AgRoboticsResearch/sroi_v2/README_ch.md

# SROI 手持数采装置 / 草莓采摘末端执行器

一套用于草莓采摘的**末端执行器**，具备两种使用形态：

- **手持数据采集形态** —— 由握把 + 板机式「录制触发按键」驱动，配合 RealSense D405 相机与空间定位 Tracker，用于采集遥操作 / 示教数据。
- **关节电机形态** —— 末端接口对接关节电机外法兰，由电机直接驱动，可挂载于机械臂执行实际采摘。

两种形态共用同一套「平行夹爪 + 直线导轨」传动末端，仅更换「摇杆转接件」与驱动源即可切换。

> 想复刻？准备材料看 [BOM 清单](BOM.md)，照着 [装配指南](#装配指南) 组装即可。

---

## 目录结构

```
第三版设计/
├── 3DModel/                 # SolidWorks 源文件
│   ├── *.SLDPRT             # 零件(自绘)
│   ├── *.SLDASM             # 装配体(手持 / 关节电机两套)
│   ├── 五金件/              # 紧固件 / 轴承参考模型(不打印，仅供装配对照)
│   └── STL/                 # 用于 3D 打印的导出件
├── BOM.md                   # 物料清单(唯一权威来源)
└── README.md
```

> `STL/` 仅包含**需要 3D 打印**的零件；标准件(直线导轨、滑块、轴承)在 `3DModel/` 下提供 `.SLDPRT` 仅供装配参考，**需外购**。

---

## 机构原理

末端采用 **摇杆 + 连杆 + 直线导轨** 的传动方案，把单一旋转输入转换为夹爪的平行开合：

```
手持：按下 按钮(线性) ──▶ 核心块转轴上的 U 型凸轮槽 ──▶ 转轴(旋转)
电机：电机轴 ──▶ 摇杆-转接电机 ──▶ 摇杆(旋转)
                                  │
                                  ▼
                        摇杆(旋转 5° → 50°)
                                  │  连杆 ×2
                                  ▼
              转接块 ── MGN9C 滑块 ── 沿 MGN9 导轨平移
                                  │
                                  ▼
                         平行夹爪 开 / 合
        松手后由按钮腔内的压簧提供回复力(夹爪自动张开)。
```

**关键传动参数(小开度配置)：**

| 参数 | 数值 |
|---|---|
| 摇杆旋转行程 | 45°(5° → 50°) |
| 对应滑块行程 | 24 mm |
| 当前导轨长度 | MGN9 156 mm(全开 ~96 mm) |

> **设计取舍**：圆弧形凸轮槽虽意图让传动更平顺，但实测会在中段产生「夹爪不动 → 冲击」的死区，反而更难控制；最终采用**直线的 U 型槽**，并在闭合段调整角度以放大夹持力——这是平顺性与夹持力之间的折中解(详见 [版本差异](#版本差异))。

---

## 物料清单 (BOM)

完整物料清单维护在独立文件中：**👉 [BOM.md](BOM.md)**

概览：18 类 3D 打印件 · 杯头/沉头/平头内六角螺丝 · 内六角打塞螺丝(M4 台阶螺丝)· MGN9 + MGN5 直线导轨 · MR115 法兰轴承 · D405 / Tracker / Raspberry Pi / 电池。

> BOM 是「购物清单」(按规格汇总数量)，下方装配指南是「装在哪」(每步列出该步用到的件)。调整数量请编辑 `BOM.md`，本 README 不重复维护。

---

## 装配指南

> 全程**未使用热熔螺母**：机牙螺丝直接自攻拧入 3D 打印件。攻丝时会因摩擦发热使 PLA 变软，影响螺纹质量——建议两颗螺丝**逐步交替拧入**，且**先用螺丝预攻一遍螺纹**、退出来、正式装配时再拧入，这样也能更好地控制垂直度。
>
> 各步骤的分步图片待补充。
>
> **装配顺序**：步骤一~五各模块相互独立，可分别单独组装；步骤六(核心块)与步骤七(总装)需交叉进行(顶盖最后盖)，详见步骤六。

### 步骤一：树莓派盒子组装

1. 树莓派上四个固定通孔需先用 **Φ3 钻头**扩孔(原尺寸略小于 Φ3)。
2. 连接**录制触发按键**的 **3-pin 线**需提前焊接到树莓派针脚。
3. 将树莓派放入**盒子-底**，靠近 40-pin 排针的两个孔用于拧螺丝，把树莓派与盒子-底固定。
   - **2 × 杯头内六角 M3×6**
4. 盖上**墨水屏**(一定要先拧上步骤 3 的固定螺丝，再盖墨水屏，否则干涉)。
5. 盖上盒子顶盖，从底部拧螺丝把顶盖锁在底座上。
   - **2 × 沉头内六角 M3×10**

> 装好后：SD 卡、电源按钮/指示灯、Type-C 供电口、Micro-HDMI 口均预留了窗口；其中一个 Micro-HDMI 口位置留了走录制按键线的空间；墨水屏观察窗与屏体之间留了 ~1 mm 缝隙，加上 USB 口处的缝隙，整体具备良好通风。

### 步骤二：摇杆组装

1. 摇杆为分件打印以提升质量：通用部分是摇臂，下接圆柱体；按「转接关节电机」或「转接手持装置」设计了两个圆柱体。先用四颗螺丝把摇杆两部分组合起来。**接关节电机**时组合无方向要求；**接手持装置**时组合有特定方向要求(后续可优化为无需区分方向)。
   - **4 × 杯头内六角 M3×8**
2. 摇杆两端预设 **Φ3.6 通孔**用来拧 M4 螺丝(带倒角便于拧入)，用机牙螺丝当自攻螺丝。建议两颗螺丝**逐步交替拧入攻丝**，中间留散热时间；并**先预攻一遍再正式装配**(见上方总则)，以控制与安装平面的垂直度。
   - **2 × 内六角打塞螺丝 M4×Φ5×6**(Φ5 为光杆直径，6 为光杆长度)
3. **(手持装置)**圆柱部分前后各安装一个法兰轴承(同轴)，中间穿一颗打塞螺丝拧入核心块预留孔。后侧法兰轴承嵌入的 Φ11 孔做了倒角，嵌入时会额外沉下一些，这是有意为之；尾部轴承与核心块接触处加一个垫片作隔离，确保旋转不受阻。此处尽量**垂直拧入**——虽自攻孔有自校准作用，但拧歪会让转轴与核心块端面不垂直，影响整体工作。
   - **2 × 法兰轴承 MR115 5×11×5**
   - **1 × 内六角打塞螺丝 M4×Φ5×12**
   - **1 × 轴承端面平垫圈 5×8×0.5**
4. **(关节电机)**电机转子法兰上有 6 个螺纹孔，装摇杆时只用其中 4 个。
   - **4 × 杯头内六角 M3×8**

### 步骤三：平行夹爪组装

1. 取 156 mm 长 **MGN9 导轨**一条、**MGN9C 滑块**两个。
2. 取两块**转接板**(同时连接滑块、夹爪、连杆)，固定到 MGN9C 滑块上。完全锁紧前尽量手动调整两块转接板使其平行——其安装精度直接影响后续夹爪精度。转接板安装**有方向要求**，参考图示。
   - **8 × 杯头内六角 M3×6**
3. 将夹爪固定到转接板(转接板上 Φ2.6 通孔，机牙螺丝自攻，带倒角)。完全锁紧前手动调整夹爪位置，使其闭合时尽量不错位。
   - **8 × 杯头内六角 M3×8**
4. 在夹爪预留位置贴上 **AprilTag**。
5. 取两根连杆，每根套两个法兰轴承(方向见图)。
   - **4 × 法兰轴承 MR115 5×11×5**
6. 将连杆与转接板组合：打塞螺丝套入法兰轴承后拧入转接板预留孔(自攻)，尽量保证螺丝轴线与安装平面垂直以获得更好的传动质量。安装**有方向要求**，见图示。
   - **2 × 内六角打塞螺丝 M4×Φ5×6**

### 步骤四：相机与相机支架组装

1. 相机支架适配 D405，RGB 镜头对准装置中心。支架背后两个沉头孔用于连接 D405，并预留了走数据线的位置。
   - **2 × 沉头内六角 M3×8**
2. **(选配)**若不用 ORB-SLAM 计算轨迹，可使用 HTC Tracker：先装到转接板上(转接板有凸起用于 Tracker 限位)，再用单颗螺丝固定。
   - **1 × 平头内六角 1/4″-20 × 5/16″**(≈ M6.35×7.94)
3. **(选配)**Tracker 转接板与相机支架侧面连接：转接板上设预置螺母的槽(可提前埋入螺母且不掉出)，相机支架上是沉头孔。
   - **2 × 沉头内六角 M3×12**
   - **2 × 普通螺母 M3**

### 步骤五：握把组装

1. 组装录制按键：先给按键安上单通铜柱。
   - **2 × 单通铜柱 M3×6+3**
   - **2 × 普通螺母 M3**
2. 将录制按键固定到握把内部(需要较长的手)，握把侧面两个沉头孔。
   - **2 × 沉头内六角 M3×8**
3. 组装握把底盖的充电口：将电池的 **Type-C 母座**嵌入底盖预留空腔，两根导线穿过充电口配件预设的 U 型槽，再通过充电口配件把母座严格约束在空腔内，最后把配件固定到底盖。
   - **1 × 杯头内六角 M3×6**
4. 将电池塞入握把，Type-C 公头(输出端)与录制按键的导线均从底盖的过线孔引出(整理一下导线，并不困难)。
5. 将握把底盖安装到握把(底部两个沉头孔)。
   - **2 × 沉头内六角 M3×8**

### 步骤六：核心块组装

> 核心块本身也是一个模块，但它与步骤七总装必须**交叉进行**：核心块一旦合上顶盖，连接摇杆、握把的螺丝孔会被挡住而难以拧入。因此先把步骤一~五各模块单独装好，再按下面顺序边装核心块、边把摇杆和握把接到核心块上，**顶盖留到最后**再盖。

1. 取导轨座，在用于连接相机支架的位置**预先埋入 3 个螺母**(六边形沉孔设计成埋入后不会掉出)。
   - **3 × 普通螺母 M3**
2. 将导轨座与核心块组装：导轨座上的六个通孔原本用于连接关节电机外法兰，手持装置不过是把电机换成了核心块，通过合理传动设置即可手动控制夹爪开合。导轨座与核心块之间用四颗螺丝固定。
   - **4 × 杯头内六角 M3×10**
3. 准备 **40 mm 的 MGN5 导轨**一根、MGN5C 滑块一个，将导轨固定到核心块对应的安装位置。
   - **3 × MGN5 导轨专用螺丝 M2×7**(圆头十字，市面普通 M2 机牙螺丝可能不适配)
4. 组装按钮：按钮由一个 3D 打印件和一个**外螺纹圆柱销**组合。圆柱销拧入时需较好垂直度——经验上可先用杯头内六角螺丝手动预攻丝一遍，再拧入圆柱销(圆柱销是一字，拧起来较累也易拧歪)。
   - **1 × 外螺纹圆柱销 M3×5**(M3 螺纹长约 4 mm，圆柱销部分 Φ4×5)

> **以下与总装交叉进行，顶盖留到最后。**

5. **连接摇杆与核心块**(此步本属总装，但顶盖会挡住螺丝，必须在合盖前做)：把装好法兰轴承的摇杆转轴拧入核心块预留孔，尽量垂直拧入。细节见步骤二.3。
6. **置入弹簧与按钮**：在核心块预设的圆柱形槽里放入**弹簧**，把按钮置入滑槽——此时按钮上的圆柱销应滑入摇杆圆柱部分的 U 型槽，按动按钮应能带动摇杆转动。将按钮与 MGN5 标准块固定(导轨 + 滑块提供按钮直线运动约束)。完全锁紧前调整按钮位置，使其尽量不与管道内壁摩擦；调整合适时按动应非常顺滑。
   - **2 × 杯头内六角 M2×6**
   - **2 × 平垫圈 2×4×0.5**
   - **1 × 压簧 0.6×8.5×45**(线径×外径×长度)
7. **安装握把**(同理需在合盖前做)：核心块上有 3 个预设通孔用于连接握把。
   - **3 × 杯头内六角 M3×8**
8. **最后盖核心块顶盖**(主要用途是防止按钮弹出)。此时摇杆、握把均已接到核心块。根据使用场景，可选**全行程**或**半行程**顶盖。
   - **2 × 平头内六角 M4×10**

### 步骤七：总装

> 摇杆与核心块、握把与核心块的连接已在步骤六(合盖前)完成。本步把其余模块接到核心块 / 导轨座 / 握把上。

1. 将平行夹爪组合体的导轨固定到核心块的导轨座上，完全拧紧前建议用手调整一下导轨位置。
   - **4 × 杯头内六角 M3×8**
2. 将相机支架与导轨座组装(导轨座上已预埋螺母，见步骤六.1)。
   - **3 × 杯头内六角 M3×12**
3. 将树莓派盒子固定到握把(握把偏下位置两个通孔)。组装完毕后盒子底缘与握把底缘齐平，可竖放稳固立于桌面。
   - **2 × 沉头内六角 M3×10**

---

## 版本差异

### 第一版 → 第二版(限位方式)
- **V1 问题**：夹爪滑动的限位完全靠打印件本身实现，使用中明显卡顿。
- **V2 尝试**：改用「光轴 + 铜套」约束(安装空间仅 10 mm，找不到这么小的直线轴承)。
- **V2 结果**：比纯 3D 打印更卡——滑动摩擦必须带间隙，不稳定；纯打印虽顺滑但有晃动，传动时仍会卡顿。

### 第二版 → 第三版(夹爪闭合 / 夹持力 / 传动)
- **夹爪闭合力不足**(当前装置的主要缺陷)：夹爪需带刀片并剪断草莓茎；手持采集时也需能徒手剪下草莓，但拇指控制的按键无法向夹爪传导足够大的力。
  - 改进：改动摇杆与连杆长度，在闭合段放大作用力——**缩短摇杆**(更大闭合力矩)、**加长连杆**。
- **导轨过长**：当前 156 mm 导轨全开 ~96 mm，对草莓精细采摘过大(约需 40 mm 行程)。缩短导轨可让整体更小更美观——当前先不调整，列为可选优化。
- **传动顺滑度**：换用 **MGN9 直线导轨**后丝般顺滑——此前的卡顿本质上都源于传动不够顺滑。
- **凸轮槽定型**：圆弧槽会在中段产生死区与冲击，效果差；最终采用**直线 U 型槽**，并在闭合段调整角度放大夹持力(平顺性与夹持力的折中)。为约束按钮直线运动，引入 **MGN5 导轨**，核心块据此重新设计。
- **相机支架 / Tracker**：D405 支架精简到只保留安装孔位、体积最小；Tracker 安装板可整体拆装，Tracker 中心置于相机正后方以简化 TF 变换。
- **导轨座螺母孔**：3 处内嵌螺母孔改为「卡入后不掉落」尺寸，方便安装。
- **树莓派盒子**：插口处尺寸优化；底盖下方加厚，落地更稳，避免墨水屏附近被暴力按坏。

---

## 已知局限 / 后续优化

- 夹爪尚未做**刀片槽**及刀片固定方案，需验证能否徒手剪断草莓茎。
- 按键目前无法使用最大行程；凸轮槽仍有细调空间，目标「按键线性 ↔ 转轴线性转动」。
- 导轨可缩短(156 mm → 满足 ~40 mm 行程)以缩小整体体积。

---

## 许可 / 说明

本项目 SolidWorks 源文件、STL 及文档用于内部研发与数据采集。如需复刻，请务必对照装配体(`.SLDASM`)核实数量与规格——[BOM.md](BOM.md) 中标 `※` 的项为对称结构推断值。
