AgRoboticsResearch/sroi_v2/(list of files, cad)

Other CAD files:
3DModel/采摘末端装配体-手持.SLDASM
3DModel/采摘末端装配体-接关节电机（用于导出）.SLDASM
3DModel/采摘末端装配体-接关节电机.SLDASM
3DModel/STL/for urdf/右夹爪.STL
3DModel/STL/手持部分-顶盖.STL
3DModel/五金件/杯头内六角-M3_8.SLDPRT
3DModel/达妙4310关节电机.stp
3DModel/STL/for urdf/末端装配体.STL
3DModel/STL/导轨座-与关节电机外法兰固定（微调导轨孔位）.STL
3DModel/五金件/沉头内六角-M3_6.SLDPRT
3DModel/STL/for urdf/左夹爪.STL
3DModel/五金件/固定N5导轨专用螺丝-M2_7.SLDPRT
3DModel/D405.SLDPRT
3DModel/STL/for urdf/末端基座.STL
3DModel/五金件/平垫圈-M2_4_0.5.SLDPRT
3DModel/五金件/内六角打塞螺丝-5_6_M4.SLDPRT
3DModel/五金件/杯头内六角-M3_6.SLDPRT
3DModel/连接件-固定在夹爪电机上.SLDPRT
3DModel/五金件/沉头内六角-M3_8.SLDPRT
3DModel/转接块-转接滑块和夹爪.SLDPRT
3DModel/五金件/平头内六角-M4_10.SLDPRT
3DModel/连接件-固定在J6关节电机上.SLDPRT
3DModel/五金件/内六角打塞螺丝-5_12_M4.SLDPRT
3DModel/摇杆-转接电机.SLDPRT
3DModel/五金件/外螺纹销钉-M3_5.SLDPRT
3DModel/握把-底盖.SLDPRT
3DModel/五金件/杯头内六角-M3_12.SLDPRT
3DModel/树莓派盒子-盖.SLDPRT
3DModel/五金件/普通螺母-M3.SLDPRT
3DModel/手持部分-核心块.SLDPRT
3DModel/五金件/轴承端面平垫.SLDPRT
3DModel/按钮.SLDPRT
3DModel/五金件/法兰轴承-5_11_5.SLDPRT
3DModel/连杆-连接摇杆和转接块.SLDPRT
3DModel/五金件/沉头内六角-M3_12.SLDPRT
3DModel/摇杆-转接手持装置.SLDPRT
3DModel/MGN9导轨-156mm.SLDPRT
3DModel/五金件/沉头内六角-M3_10.SLDPRT
3DModel/五金件/杯头内六角-M2_6.SLDPRT
3DModel/握把-主体.SLDPRT
3DModel/五金件/杯头内六角-M3_10.SLDPRT
3DModel/树莓派盒子-底.SLDPRT
3DModel/Tracker安装板.SLDPRT
3DModel/MGN9C滑块.SLDPRT
3DModel/MGN5导轨-40mm.SLDPRT
3DModel/手持部分-顶盖-全行程.SLDPRT
3DModel/摇杆-摇杆通用部分.SLDPRT
3DModel/MGN5C滑块.SLDPRT
3DModel/导轨座-与关节电机外法兰固定.SLDPRT
3DModel/握把-充电口配件.SLDPRT
3DModel/夹爪.SLDPRT
3DModel/手持部分-顶盖-半行程.SLDPRT
3DModel/相机支架-D405.SLDPRT
3DModel/STL/Tracker安装板.STL
3DModel/STL/夹爪.STL
3DModel/STL/导轨座-与关节电机外法兰固定.STL
3DModel/STL/手持部分-核心块.STL
3DModel/STL/手持部分-顶盖-半行程.STL
3DModel/STL/按钮.STL
3DModel/STL/握把-主体.STL
3DModel/STL/握把-充电口配件.STL
3DModel/STL/握把-底盖.STL
3DModel/STL/摇杆-摇杆通用部分.STL
3DModel/STL/摇杆-转接手持装置.STL
3DModel/STL/摇杆-转接电机.STL
3DModel/STL/树莓派盒子-底.STL
3DModel/STL/树莓派盒子-盖.STL
3DModel/STL/相机支架-D405.STL
3DModel/STL/转接块-转接滑块和夹爪.STL
3DModel/STL/连杆-连接摇杆和转接块.STL
