AgRoboticsResearch/sroi_v2/(commit log)

2026-07-06 Add 3D models, README documentation and standalone BOM
    - Add SolidWorks source files (.SLDPRT/.SLDASM) and exported STLs for all printed parts
    - Write README: project overview, mechanism, assembly guide, design iterations
    - Add BOM.md as single source of truth for bill of materials; README links to it
    [MGN9C滑块.SLDPRT, MGN9导轨-156mm.SLDPRT, Tracker安装板.SLDPRT, Tracker安装板.STL, 夹爪.SLDPRT, 导轨座-与关节电机外法兰固定.SLDPRT, 导轨座-与关节电机外法兰固定.STL, 导轨座-与关节电机外法兰固定（微调导轨孔位）.STL]
2026-07-10 同步最新设计并启用 Git LFS
    - 更新零件(.SLDPRT)/装配体(.SLDASM)/STL 至最新版本，含本次新增模型与五金件
    - 五金件统一归入 3DModel/ 下
    - 启用 Git LFS 跟踪 CAD 二进制，防止仓库历史膨胀
    - .gitignore 补充 SolidWorks 锁文件(~$*)规则
    [MGN5C滑块.SLDPRT, MGN5导轨-40mm.SLDPRT, MGN9C滑块.SLDPRT, MGN9导轨-156mm.SLDPRT, Tracker安装板.SLDPRT, Tracker安装板.STL, 内六角打塞螺丝-5_12_M4.SLDPRT, 内六角打塞螺丝-5_6_M4.SLDPRT]
2026-07-13 完善装配说明与 BOM 清单
    - README 重写为对外版：补全 7 步装配说明、版本差异，步骤六/七改为
    核心块与总装交叉进行(顶盖最后盖)
    - BOM 补全紧固件/标准件/电子件，与装配说明对齐；区分机械按钮与录制
    触发按键；电池合并为 18650 电池组(5V/5A Type-C 输出+充电口)
    - MGN5 导轨专用螺丝规格修正为 M2x7，重命名零件文件
    - 装配体增加相机视角草图
    - .gitignore 忽略个人工作文档
    [固定N5导轨专用螺丝-M2_7.SLDPRT, 固定N5导轨专用螺丝-M2_8.SLDPRT, 采摘末端装配体-手持.SLDASM]
2026-07-17 新增英文版 README / BOM，中文原件归档为 _ch.md
    - 英文版顶部加入「中文版」链接，交叉引用锚点同步更新为英文标题
    - BOM 表中磁盘上的中文文件名保持不变，仅翻译说明文字
2026-07-20 更新采摘末端装配体（接关节电机）
    [采摘末端装配体-接关节电机.SLDASM]
2026-07-22 集成 D405 相机、J6/夹爪连接件与达妙4310电机模型；更新采摘末端装配体；导出 URDF 用 STL
    [D405.SLDPRT, 右夹爪.STL, 左夹爪.STL, 末端基座.STL, 末端装配体.STL, 杯头内六角-M3_8.SLDPRT, 沉头内六角-M3_6.SLDPRT, 转接块-转接滑块和夹爪.SLDPRT]
